williamrjackson/ScoreboardRestoration/(commit log)

2024-01-19 Speculative buzzer; comment/log tidying
    [ScoreboardLogic.ino]
2024-01-21 visitorScore > 9 bugfix; better control page
    [ScoreboardLogic.ino]
2024-01-21 disabling invisible button looks ugly on Android
2024-01-22 idle time off - interaction on bugfix
    [ScoreboardLogic.ino]
2024-01-29 Update ScoreboardLogic.ino
    Note about millis() overflow
2024-01-31 relay pin and typo
2024-02-05 color presets, tweaked to prevent visitorscore dimming
    [ScoreboardLogic.ino]
2024-02-12 Alternative 9 to differentiate 4; Spelling fix: "Possession"
    [ScoreboardLogic.ino]
2024-02-12 increased buzzer duration per orig manual
    [ScoreboardLogic.ino]
